QuentinMorel/arduino-esp8266-anemometre/(commit log)

2023-08-26 fix calcul vitesse avec resolution 0.0875 soit 20 pulse par s donne 1.75 m par s
    [arduino-esp8266-anemometre.ino]
2023-08-27 battery monitoring
2023-08-27 rain sensor OK
2023-09-02 mesure toutes les 30s en int
2023-09-22 print nb of impulses
